Deepak-EL/robro/docs/figures/foxglove_coverage_run.png

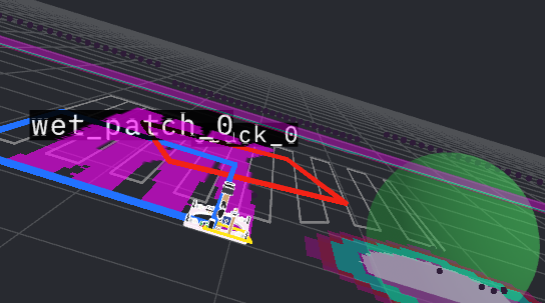
docs/figures/foxglove_coverage_run.png
