Deepak-EL/robro/docs/figures/foxglove_robot_model.png

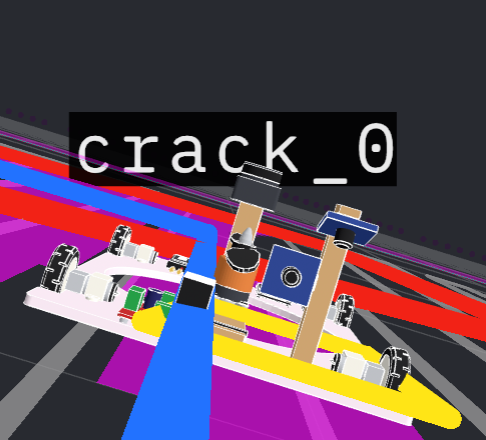
docs/figures/foxglove_robot_model.png
