Deepak-EL/robro/docs/figures/webots_goldeneye_robot_on_fitted_face.png

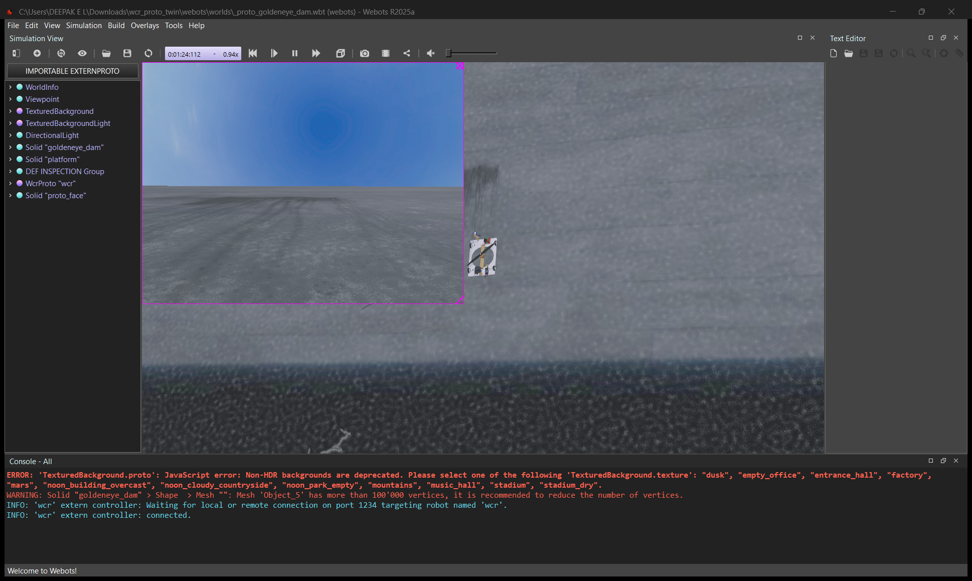
docs/figures/webots_goldeneye_robot_on_fitted_face.png
