Deepak-EL/robro/prototype_v2/cad/preview_top.png

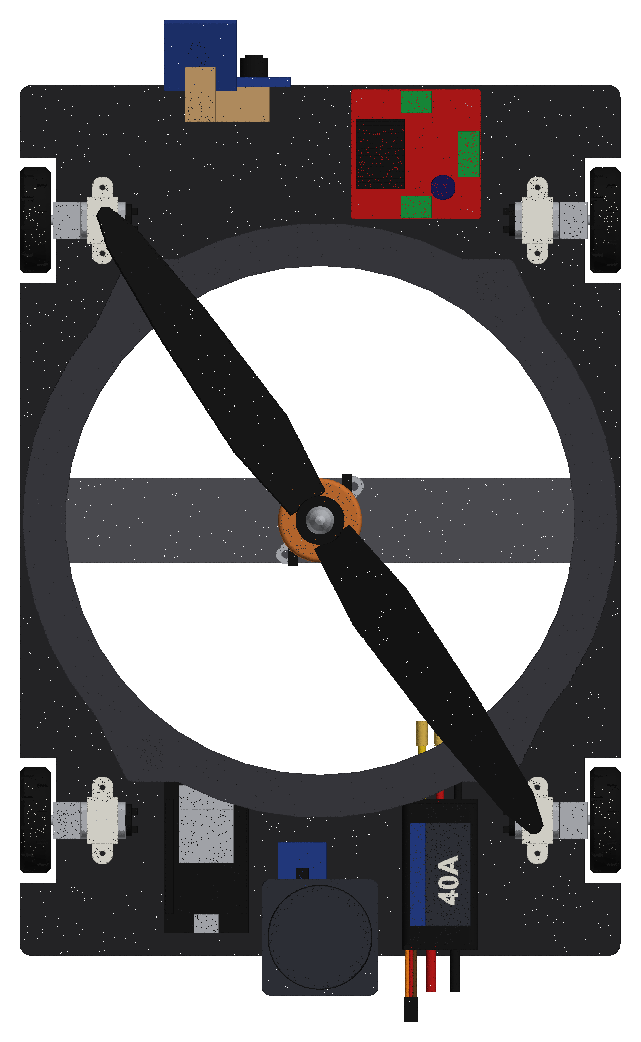
prototype_v2/cad/preview_top.png
