Deepak-EL/robro/prototype_v2/cad/urdf_check.png

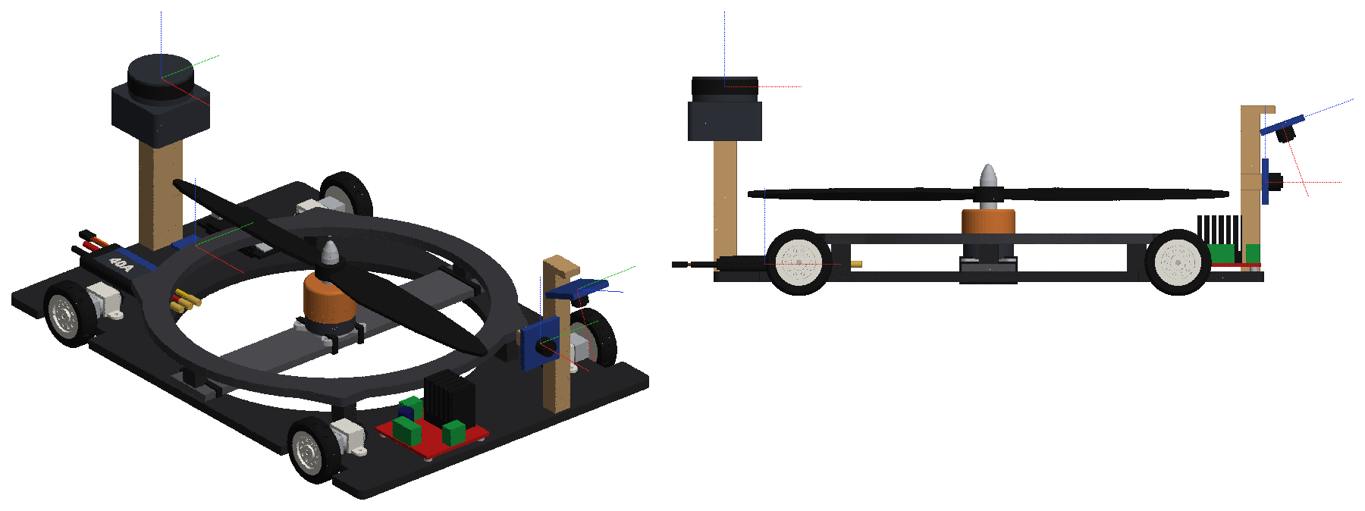
prototype_v2/cad/urdf_check.png
