Deepak-EL/robro/prototype_v2/docs/figures/hw/ref_1000kv_1045.jpg

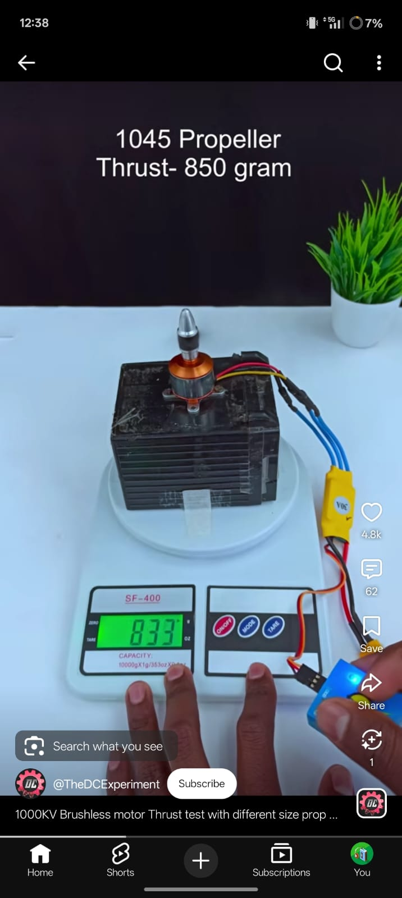
prototype_v2/docs/figures/hw/ref_1000kv_1045.jpg
