Deepak-EL/robro/prototype_v2/docs/figures/hw/ref_1000kv_6045.jpg

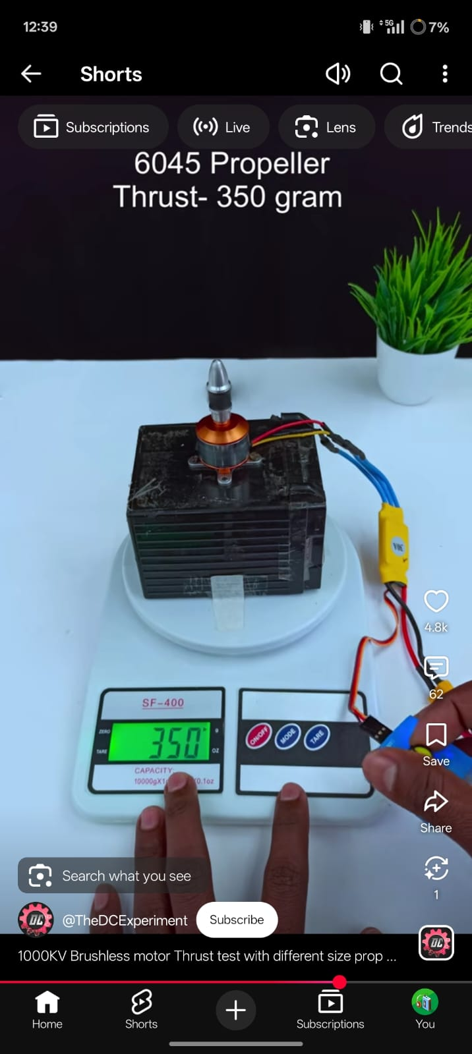
prototype_v2/docs/figures/hw/ref_1000kv_6045.jpg
