Deepak-EL/robro/prototype_v2/docs/figures/hw/robot_on_wall.jpg

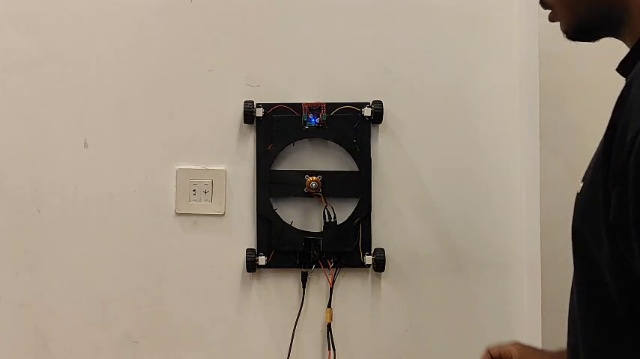
prototype_v2/docs/figures/hw/robot_on_wall.jpg
