Deepak-EL/robro/prototype_v2/docs/figures/hw/robot_weight_444g.jpg

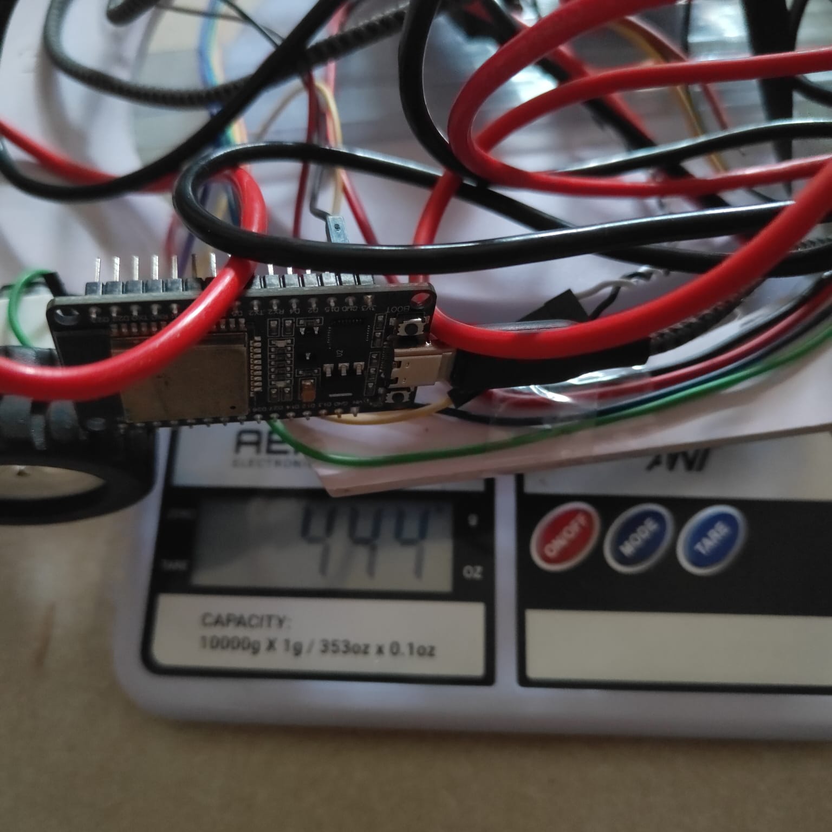
prototype_v2/docs/figures/hw/robot_weight_444g.jpg
