Deepak-EL/robro/prototype_v2/docs/figures/hw/v2_side.jpg

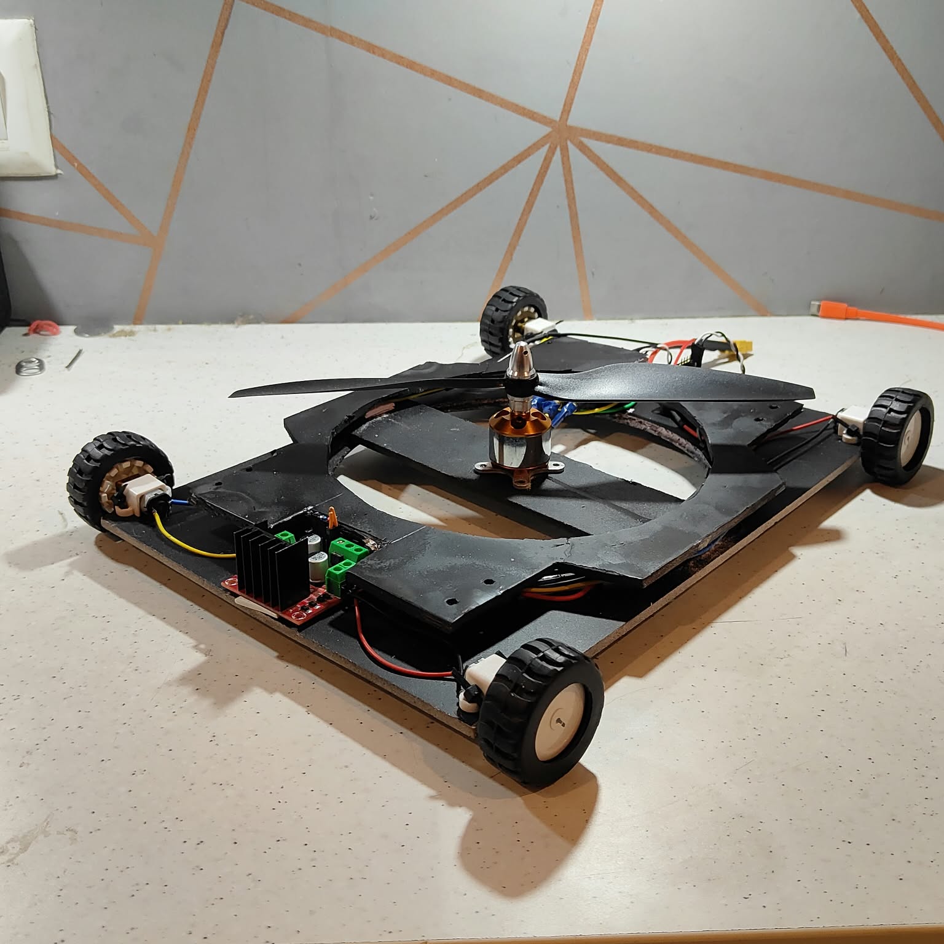
prototype_v2/docs/figures/hw/v2_side.jpg
