Deepak-EL/robro/prototype_v2/docs/figures/hw_n20_clamp.png

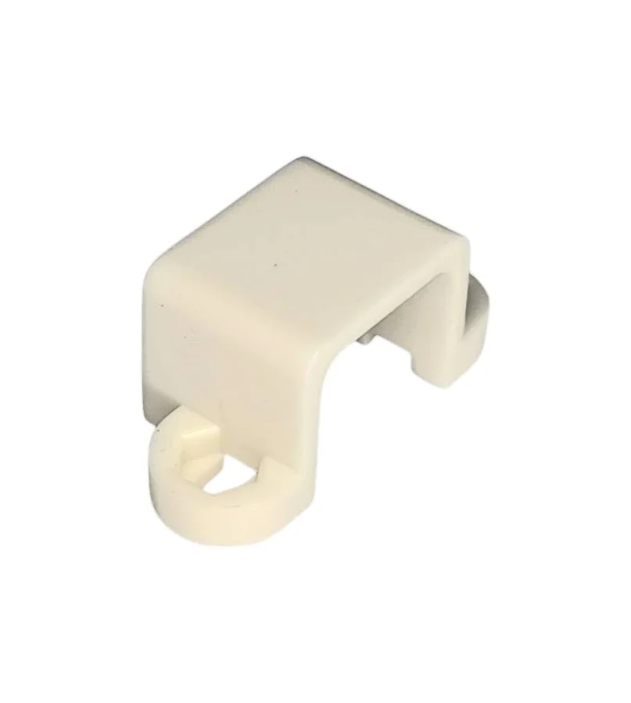
prototype_v2/docs/figures/hw_n20_clamp.png
