Deepak-EL/robro/prototype_v2/media/photos/WhatsApp Image 2026-10-24 at 18.57.05.jpeg

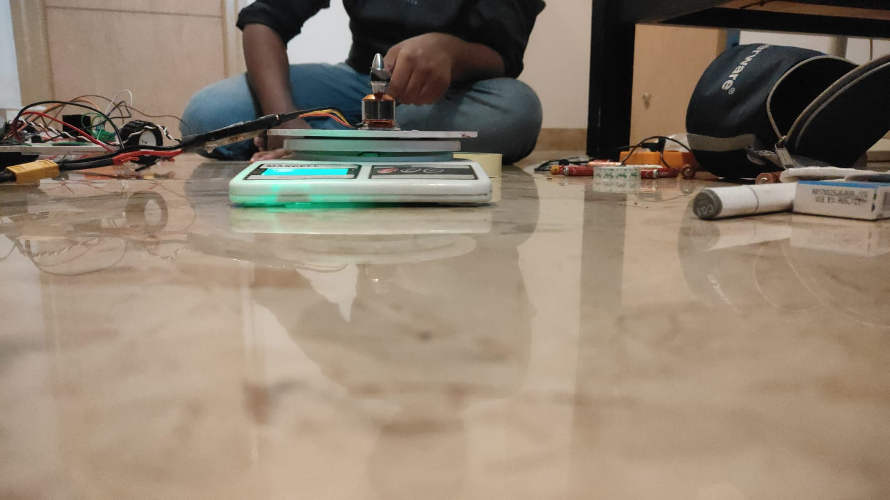
prototype_v2/media/photos/WhatsApp Image 2026-10-24 at 18.57.05.jpeg
