Deepak-EL/robro/prototype_v2/media/photos/WhatsApp Image 2026-10-27 at 12.44.45.jpeg

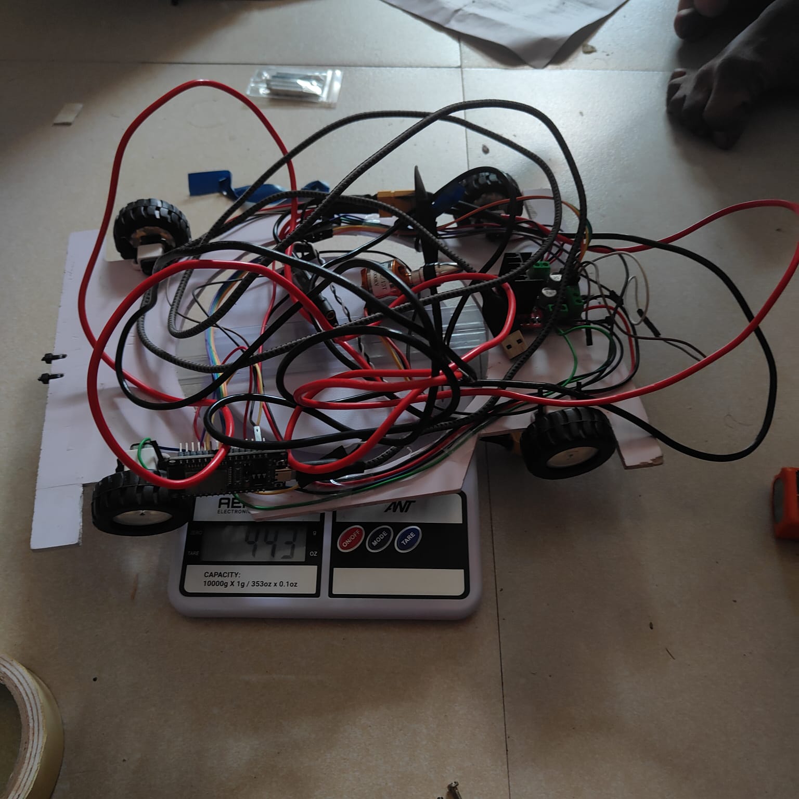
prototype_v2/media/photos/WhatsApp Image 2026-10-27 at 12.44.45.jpeg
