Deepak-EL/robro/prototype_v2/cad/wcr_proto2.step

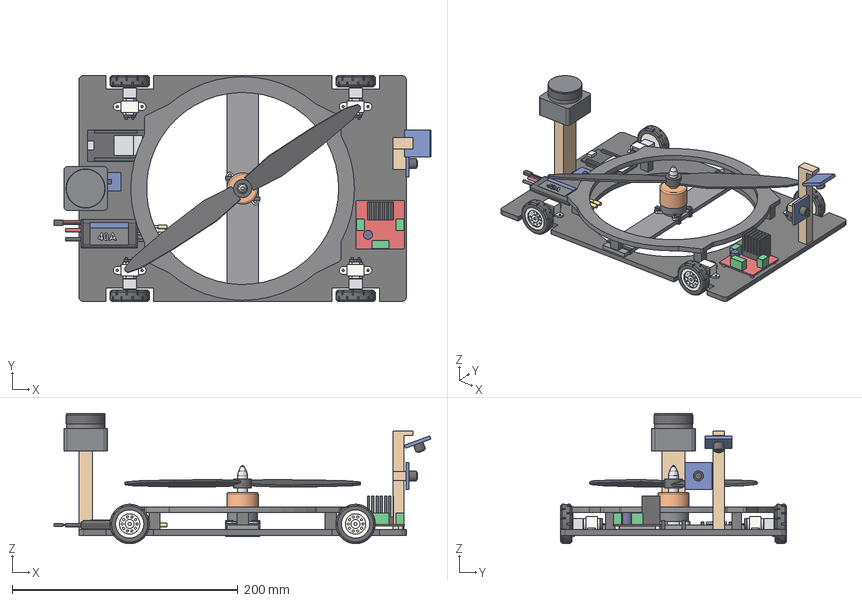
[picture p22: CAD file, 2026-11-06]
prototype_v2/cad/wcr_proto2.step
333.8 x 200.0 x 115.5 mm
foam_board
plywood_strip
top_deck
deck_spacer_0
deck_spacer_1
deck_spacer_2
deck_spacer_3
deck_spacer_4
deck_spacer_5
motor_mount
motor_stator
motor_bell
motor_shaft
zip_tie_motor_0
zip_tie_motor_1
zip_tie_strip_0
zip_tie_strip_1
propeller
spinner_nut
FL_n20_gearbox
FL_n20_can
FL_n20_endcap
FL_n20_clamp
FL_tyre
FL_hub
FR_n20_gearbox
FR_n20_can
FR_n20_endcap
FR_n20_clamp
FR_tyre
FR_hub
BL_n20_gearbox
BL_n20_can
BL_n20_endcap
BL_n20_clamp
BL_tyre
BL_hub
BR_n20_gearbox
BR_n20_can
BR_n20_endcap
BR_n20_clamp
BR_tyre
BR_hub
l298n_standoffs
l298n_pcb
l298n_heatsink
l298n_terminals
l298n_capacitor
esp32_pins
esp32_pcb
esp32_module
esp32_usb
esc_body
esc_label
esc_label_stripe
esc_label_text
esc_wires_black
esc_wires_gold
esc_wires_red
esc_wires_yellow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
