Deepak-EL/robro/prototype_v2/ros/wcr_proto2/meshes/body_2.stl

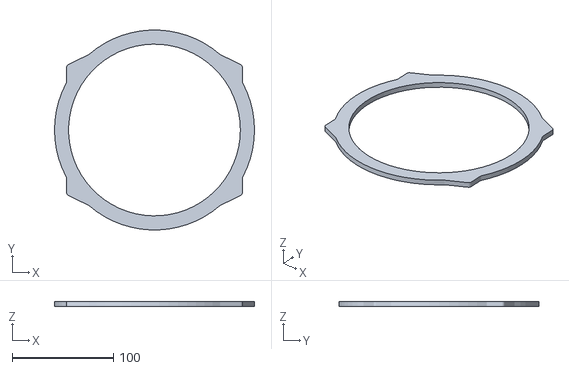
[picture p23: CAD file, 2026-11-06]
prototype_v2/ros/wcr_proto2/meshes/body_2.stl
198.0 x 197.8 x 5.00
