Deepak-EL/robro/prototype_v2/ros/wcr_proto2/meshes/body_0.stl

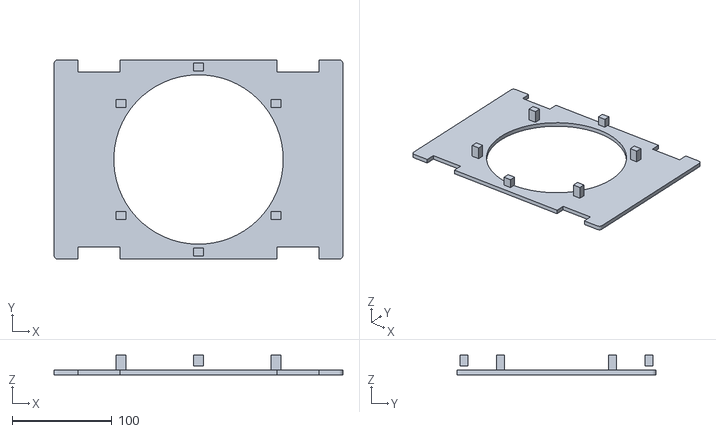
[picture p24: CAD file, 2026-11-06]
prototype_v2/ros/wcr_proto2/meshes/body_0.stl
290.0 x 200.0 x 20.0
