Deepak-EL/robro/prototype_v2/ros/wcr_proto2/meshes/body_1.stl

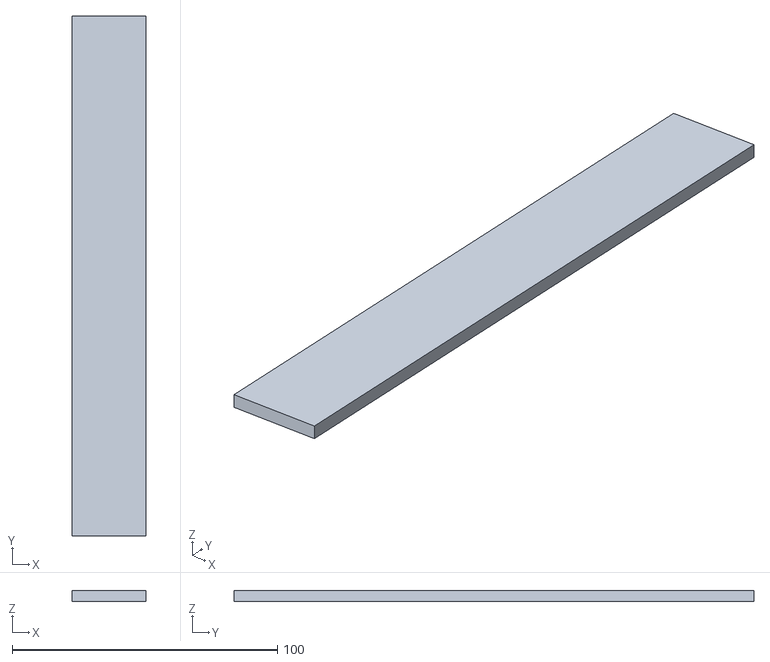
[picture p25: CAD file, 2026-11-06]
prototype_v2/ros/wcr_proto2/meshes/body_1.stl
28.0 x 196.0 x 4.00
