Deepak-EL/robro/prototype_v2/ros/wcr_proto2/meshes/body_16.stl

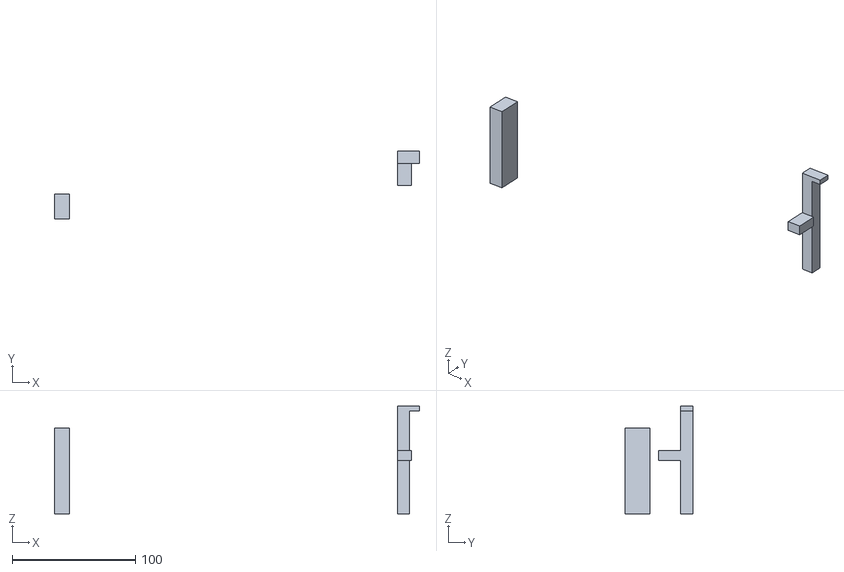
[picture p26: CAD file, 2026-11-06]
prototype_v2/ros/wcr_proto2/meshes/body_16.stl
296.0 x 55.0 x 87.5
