Deepak-EL/robro/prototype_v2/ros/wcr_proto2/meshes/body_6.stl

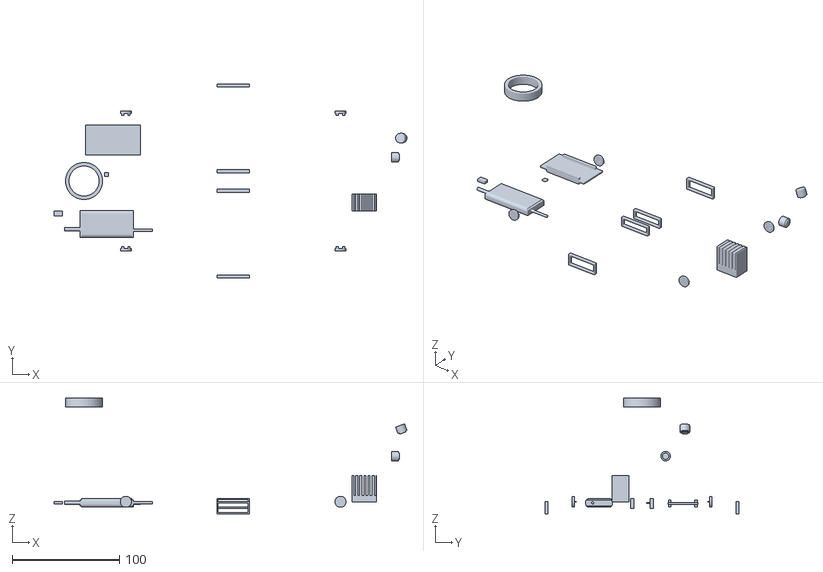
[picture p27: CAD file, 2026-11-06]
prototype_v2/ros/wcr_proto2/meshes/body_6.stl
329.0 x 181.0 x 107.7
