Deepak-EL/robro/prototype_v2/ros/wcr_proto2/meshes/body_11.stl

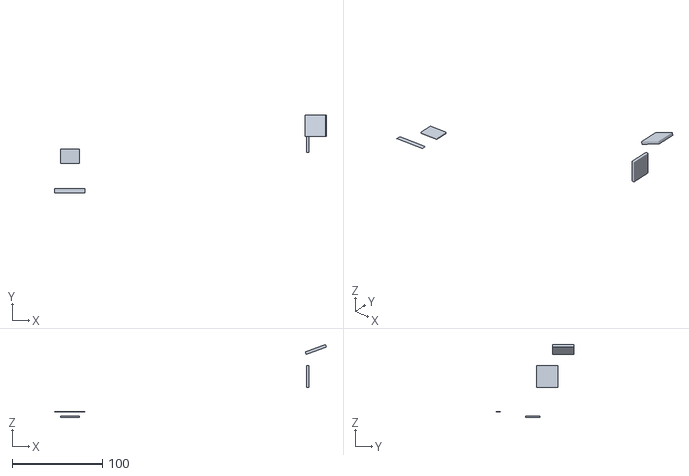
[picture p28: CAD file, 2026-11-04]
prototype_v2/ros/wcr_proto2/meshes/body_11.stl
301.8 x 87.0 x 81.0
