Deepak-EL/robro/prototype_v2/ros/wcr_proto2/meshes/body_5.stl

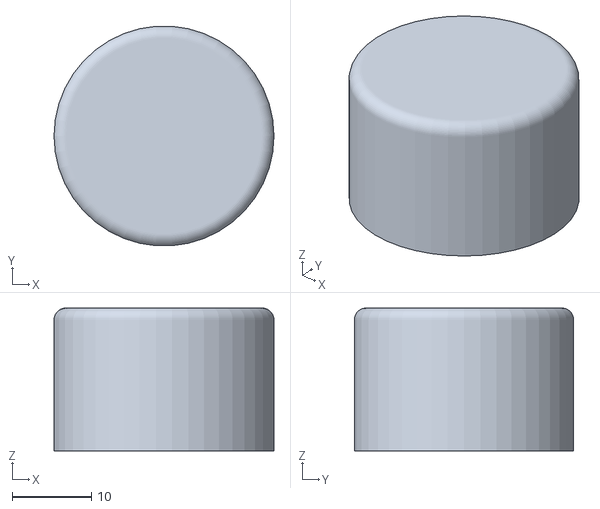
[picture p29: CAD file, 2026-11-04]
prototype_v2/ros/wcr_proto2/meshes/body_5.stl
27.7 x 27.6 x 18.0
