Deepak-EL/robro/prototype_v2/ros/wcr_proto2/meshes/body_12.stl

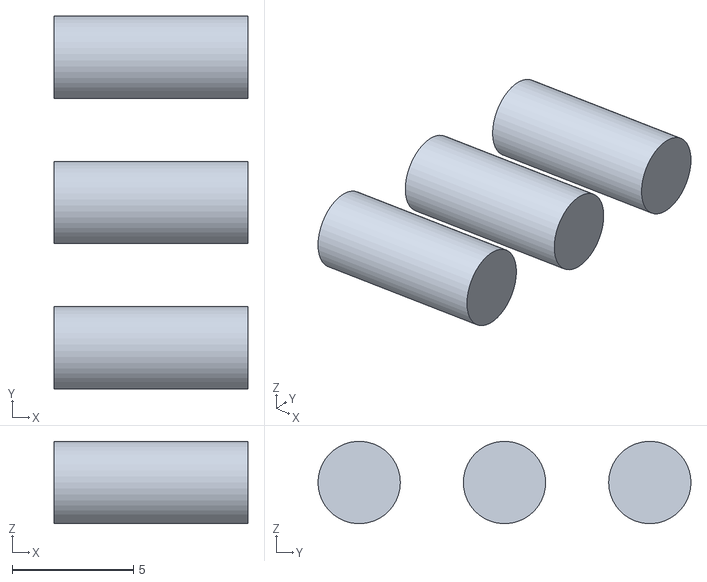
[picture p30: CAD file, 2026-11-04]
prototype_v2/ros/wcr_proto2/meshes/body_12.stl
8.00 x 15.4 x 3.39
