Deepak-EL/robro/prototype_v2/ros/wcr_proto2/meshes/prop_0.stl

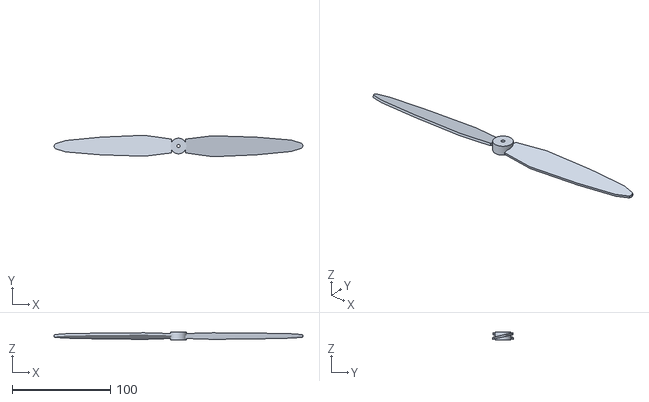
[picture p31: CAD file, 2026-11-04]
prototype_v2/ros/wcr_proto2/meshes/prop_0.stl
254.0 x 21.9 x 8.00
