Deepak-EL/robro/prototype_v2/ros/wcr_proto2/meshes/body_7.stl

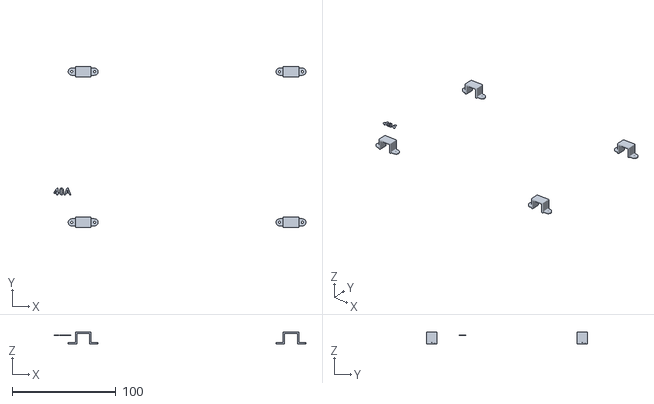
[picture p32: CAD file, 2026-11-04]
prototype_v2/ros/wcr_proto2/meshes/body_7.stl
242.5 x 155.0 x 11.7
