Deepak-EL/robro/prototype_v2/ros/wcr_proto2/meshes/body_4.stl

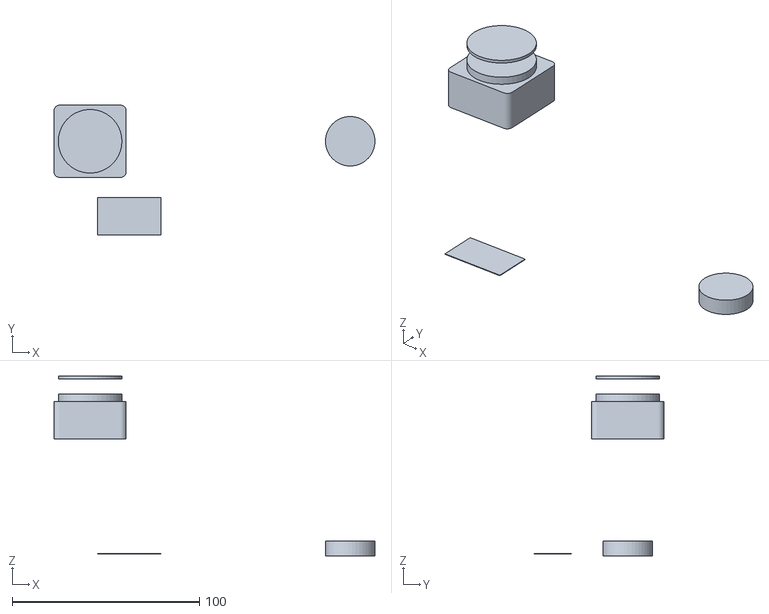
[picture p33: CAD file, 2026-11-04]
prototype_v2/ros/wcr_proto2/meshes/body_4.stl
171.6 x 69.3 x 96.0
