Deepak-EL/robro/prototype_v2/ros/wcr_proto2/meshes/body_13.stl

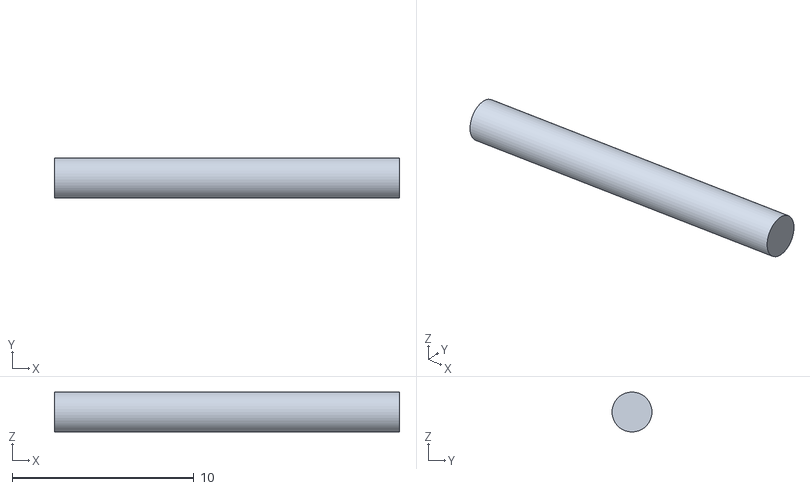
[picture p34: CAD file, 2026-11-04]
prototype_v2/ros/wcr_proto2/meshes/body_13.stl
19.0 x 2.20 x 2.19
