Deepak-EL/robro/prototype_v2/ros/wcr_proto2/meshes/wheel_0.stl

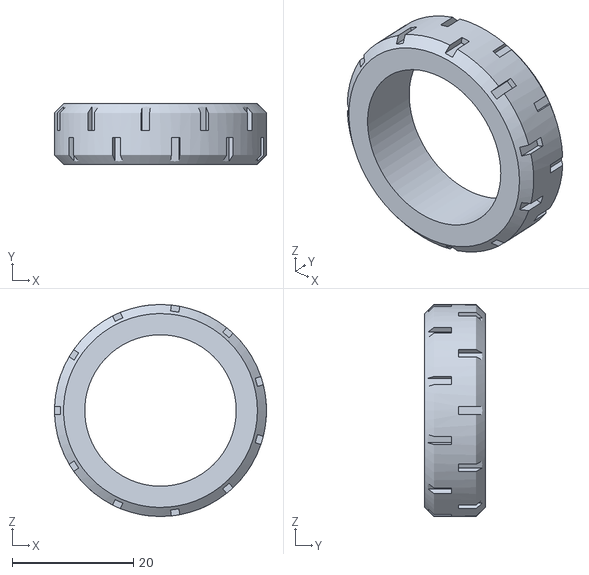
[picture p35: CAD file, 2026-11-04]
prototype_v2/ros/wcr_proto2/meshes/wheel_0.stl
35.0 x 10.0 x 35.0
