Deepak-EL/robro/prototype_v2/ros/wcr_proto2/meshes/body_15.stl

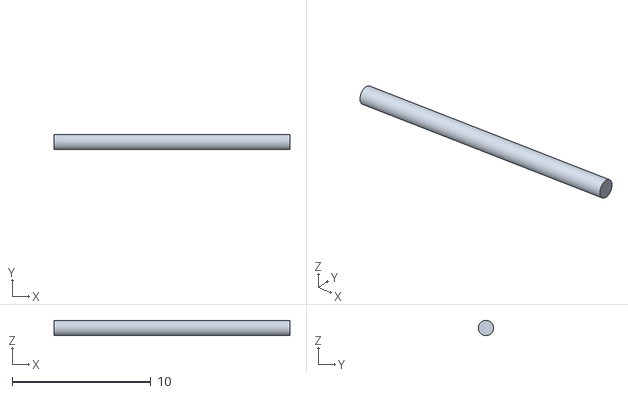
[picture p36: CAD file, 2026-11-04]
prototype_v2/ros/wcr_proto2/meshes/body_15.stl
17.0 x 1.10 x 1.10
