Deepak-EL/robro/prototype_v2/ros/wcr_proto2/meshes/wheel_1.stl

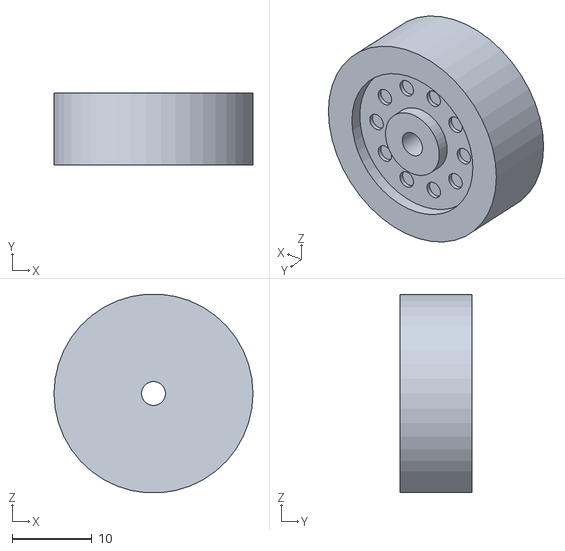
[picture p37: CAD file, 2026-11-04]
prototype_v2/ros/wcr_proto2/meshes/wheel_1.stl
25.0 x 9.00 x 24.9
