Deepak-EL/robro/prototype_v2/ros/wcr_proto2/meshes/body_10.stl

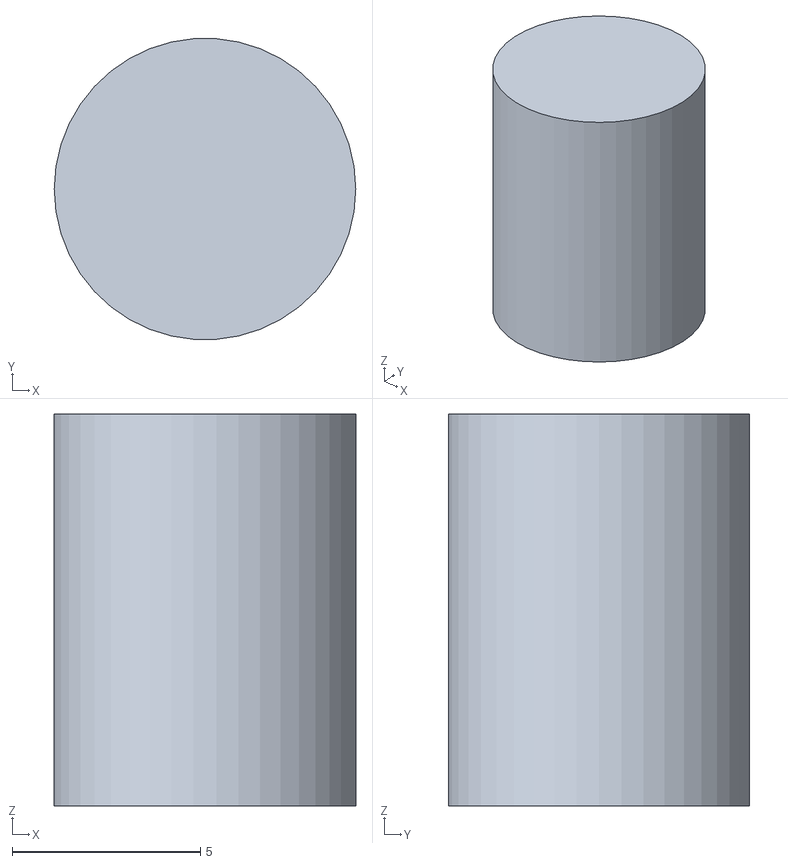
[picture p38: CAD file, 2026-11-04]
prototype_v2/ros/wcr_proto2/meshes/body_10.stl
8.00 x 7.98 x 10.4
