Deepak-EL/robro/prototype_v2/ros/wcr_proto2/meshes/body_3.stl

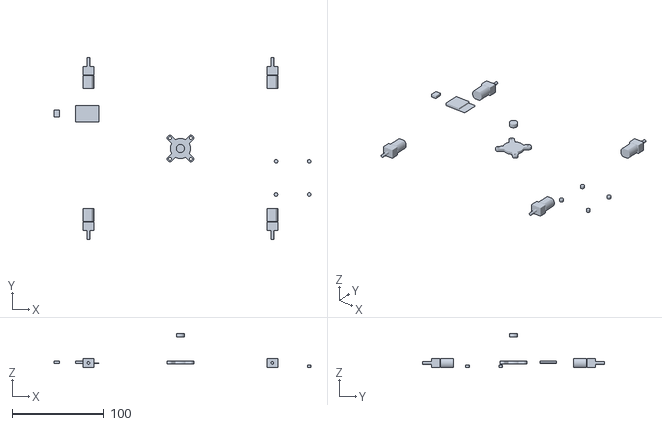
[picture p39: CAD file, 2026-11-04]
prototype_v2/ros/wcr_proto2/meshes/body_3.stl
279.5 x 198.0 x 37.0
