Deepak-EL/robro/prototype_v2/ros/wcr_proto2/meshes/body_9.stl

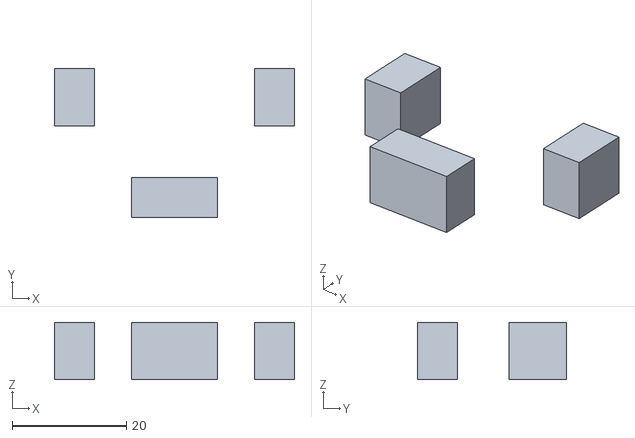
[picture p40: CAD file, 2026-11-04]
prototype_v2/ros/wcr_proto2/meshes/body_9.stl
42.0 x 26.0 x 10.0
