Deepak-EL/robro/prototype_v2/ros/wcr_proto2/meshes/prop_1.stl

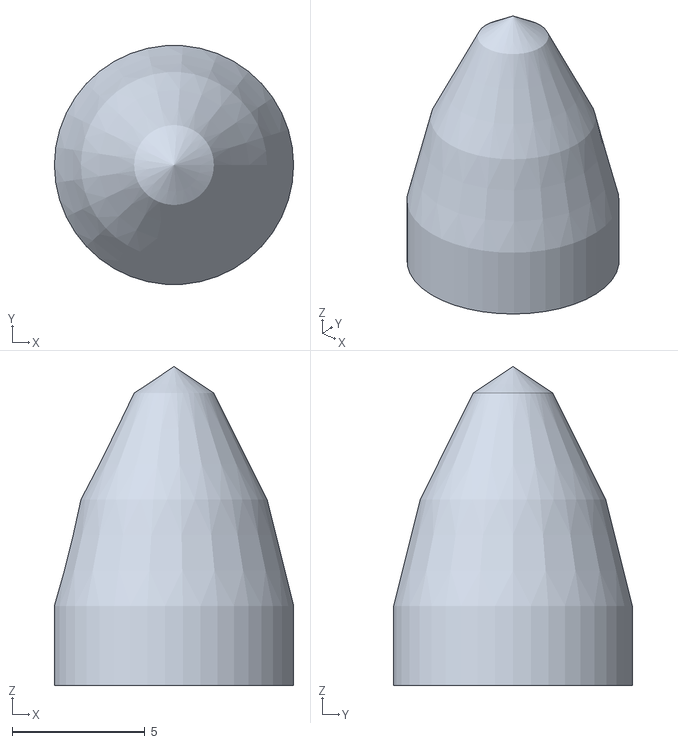
[picture p41: CAD file, 2026-11-04]
prototype_v2/ros/wcr_proto2/meshes/prop_1.stl
9.00 x 8.97 x 12.0
