Deepak-EL/robro/prototype_v2/ros/wcr_proto2/meshes/body_8.stl

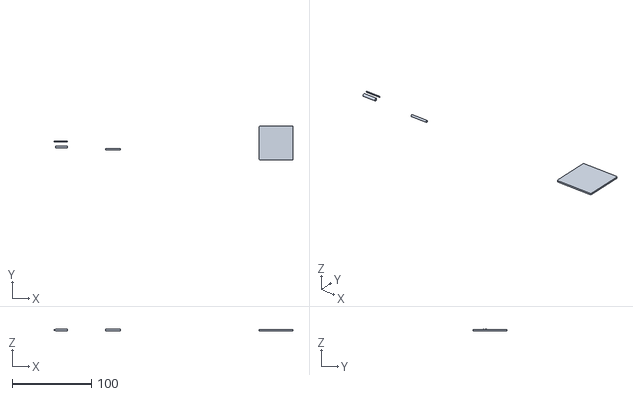
[picture p42: CAD file, 2026-11-04]
prototype_v2/ros/wcr_proto2/meshes/body_8.stl
302.5 x 43.0 x 2.99
