Deepak-EL/robro/(list of files, cad)

Other CAD files:
prototype_v2/ros/wcr_proto2/meshes/body_14.stl
prototype_v2/ros/wcr_proto2/meshes/body_0.obj
prototype_v2/ros/wcr_proto2/meshes/body_1.obj
prototype_v2/ros/wcr_proto2/meshes/body_10.obj
prototype_v2/ros/wcr_proto2/meshes/body_11.obj
prototype_v2/ros/wcr_proto2/meshes/body_12.obj
prototype_v2/ros/wcr_proto2/meshes/body_13.obj
prototype_v2/ros/wcr_proto2/meshes/body_14.obj
prototype_v2/ros/wcr_proto2/meshes/body_15.obj
prototype_v2/ros/wcr_proto2/meshes/body_16.obj
prototype_v2/ros/wcr_proto2/meshes/body_2.obj
prototype_v2/ros/wcr_proto2/meshes/body_3.obj
prototype_v2/ros/wcr_proto2/meshes/body_4.obj
prototype_v2/ros/wcr_proto2/meshes/body_5.obj
prototype_v2/ros/wcr_proto2/meshes/body_6.obj
prototype_v2/ros/wcr_proto2/meshes/body_7.obj
prototype_v2/ros/wcr_proto2/meshes/body_8.obj
prototype_v2/ros/wcr_proto2/meshes/body_9.obj
prototype_v2/ros/wcr_proto2/meshes/prop_0.obj
prototype_v2/ros/wcr_proto2/meshes/prop_1.obj
prototype_v2/ros/wcr_proto2/meshes/wheel_0.obj
prototype_v2/ros/wcr_proto2/meshes/wheel_1.obj
