Deepak-EL/robro/prototype_v2/docs/figures/wiring_diagram.png

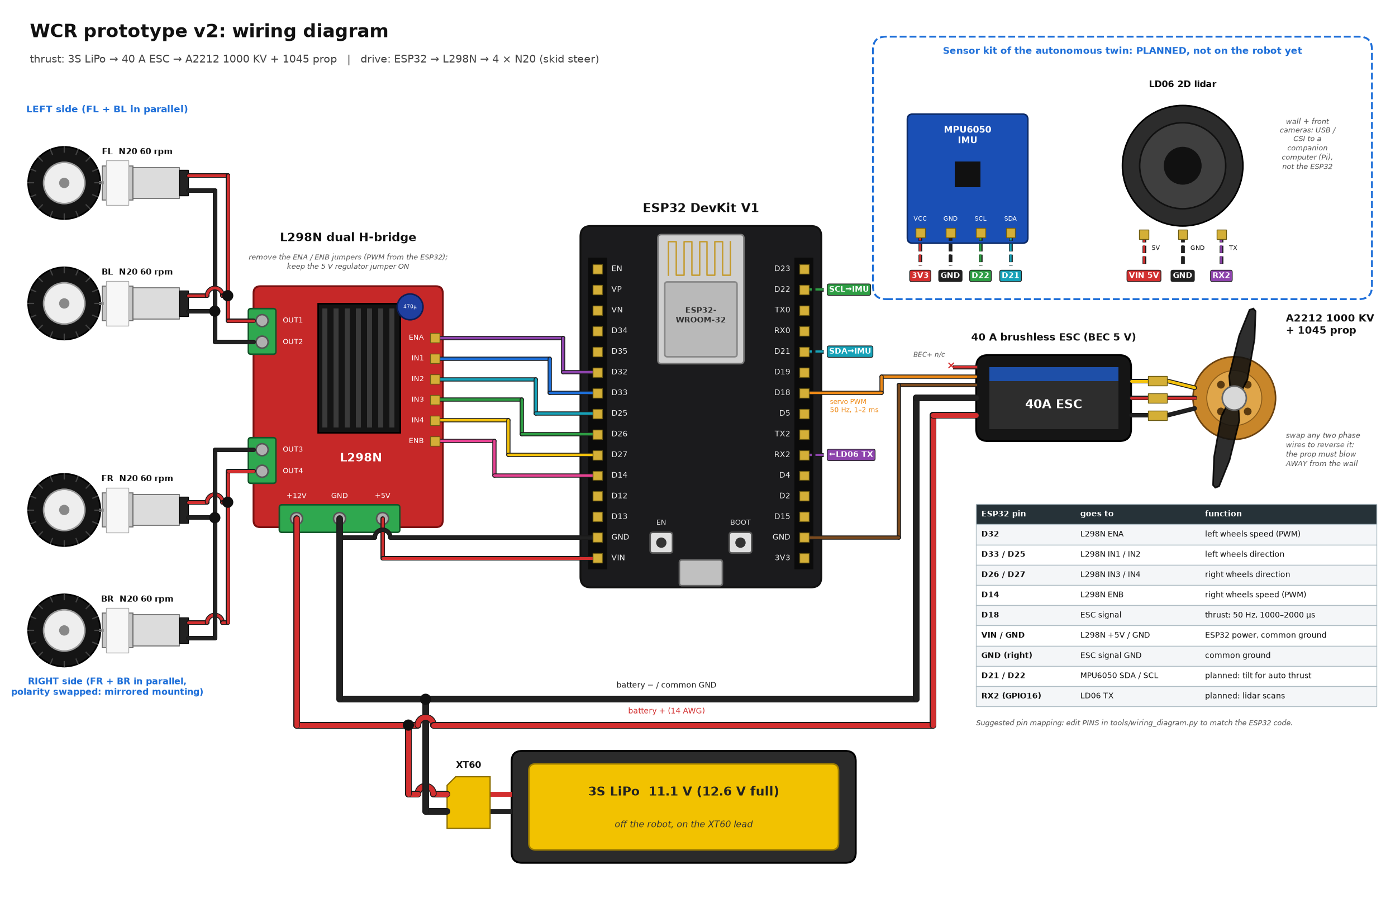
prototype_v2/docs/figures/wiring_diagram.png
