Deepak-EL/robro/prototype_v2/docs/figures/wiring_diagram_user.png

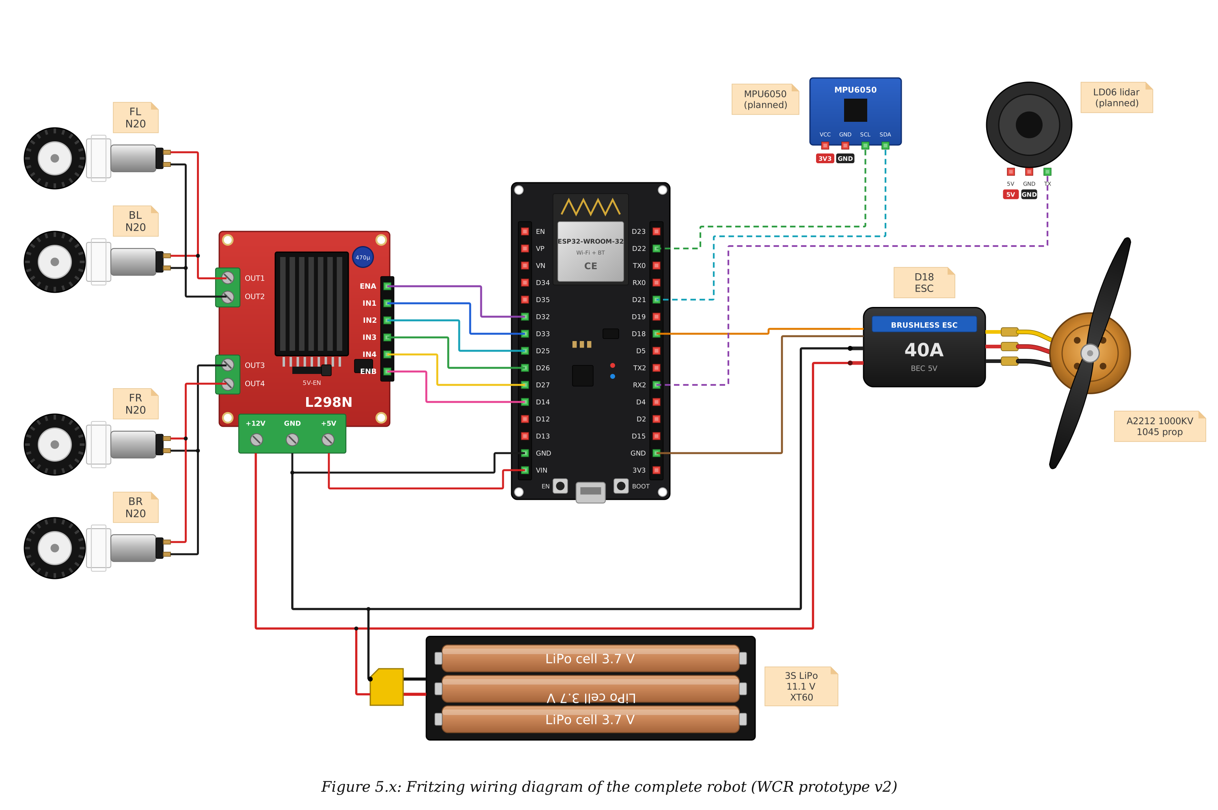
prototype_v2/docs/figures/wiring_diagram_user.png
