Deepak-EL/robro/results/final/inspection_log_goldeneye_gorge.csv

sim_time_s | id | type | s_m | t_m | x | y | z | robot_x | robot_y | robot_z | points_in_view | visible_fraction
16.5 | crack_0 | crack | 2.1 | -0.07 | -22.0589 | 0.697 | -102.4002 | -22.219 | 0.748 | -102.507 | 5 | 0.03
22.5 | wet_patch_0 | wet_patch | 2.85 | -0.5 | -22.4669 | 0.8331 | -101.6502 | -22.504 | 0.844 | -101.927 | 4 | 0.03
