Deepak-EL/robro/results/final/inspection_log_winter_dam.csv

sim_time_s | id | type | s_m | t_m | x | y | z | robot_x | robot_y | robot_z | points_in_view | visible_fraction
17.19 | crack_0 | crack | 2.8 | -0.07 | 0.07 | 1.6637 | 2.2521 | 0.239 | 1.605 | 2.172 | 6 | 0.04
23.19 | wet_patch_0 | wet_patch | 3.55 | -0.5 | 0.5 | 2.1094 | 2.8554 | 0.536 | 1.95 | 2.639 | 4 | 0.03
