Deepak-EL/robro/prototype_v2/docs/figures/hw/thrust_test_bench.jpg

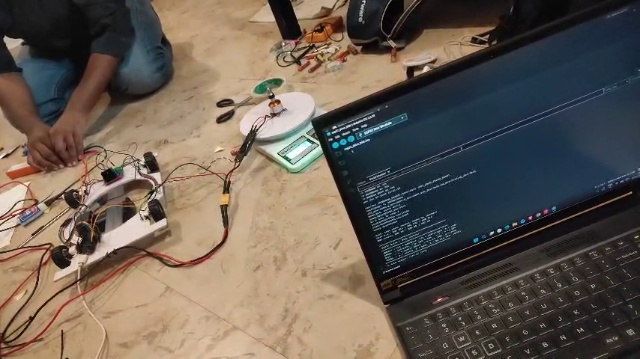
prototype_v2/docs/figures/hw/thrust_test_bench.jpg
