Deepak-EL/robro/prototype_v2/docs/figures/hw/thrust_test_scale_296g.jpg

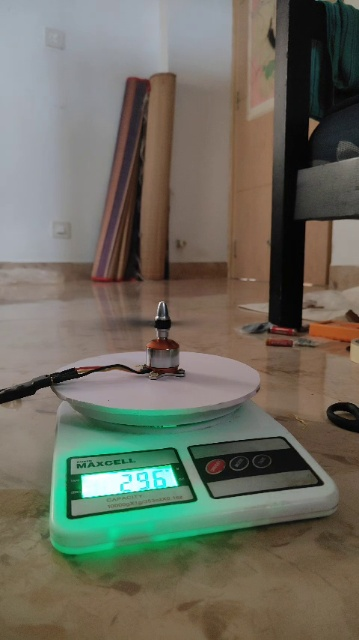
prototype_v2/docs/figures/hw/thrust_test_scale_296g.jpg
