Deepak-EL/robro/prototype_v2/results/coverage_goldeneye_dam.png

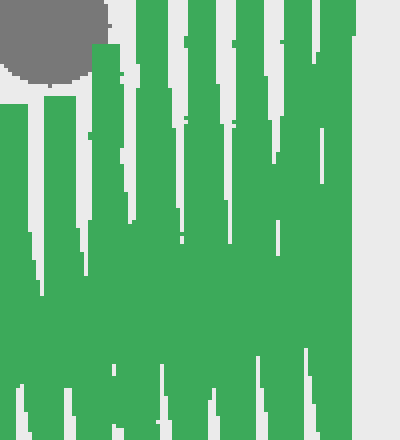
prototype_v2/results/coverage_goldeneye_dam.png
