Deepak-EL/robro/prototype_v2/results/coverage_goldeneye_gorge.png

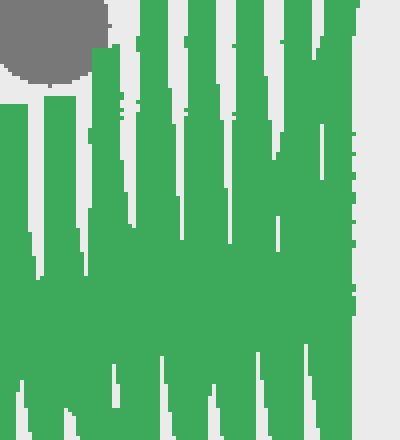
prototype_v2/results/coverage_goldeneye_gorge.png
