Deepak-EL/robro/prototype_v2/results/coverage_winter_dam.png

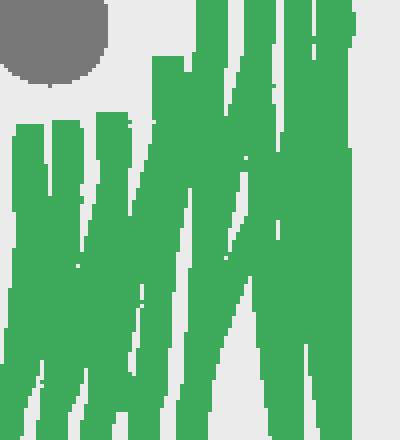
prototype_v2/results/coverage_winter_dam.png
