Deepak-EL/robro/docs/figures/issue1_winter_stuck_turning.png

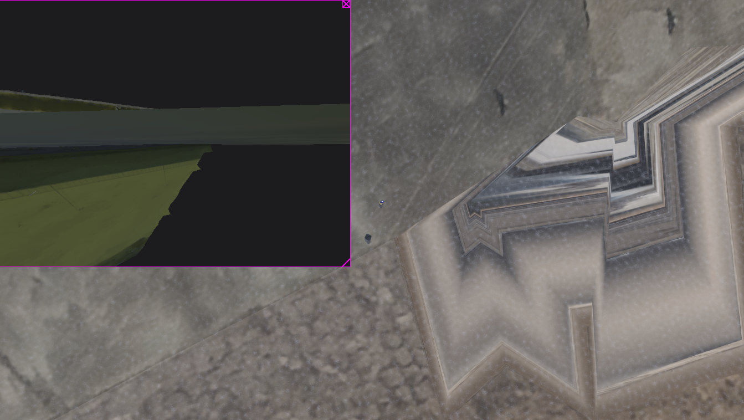
docs/figures/issue1_winter_stuck_turning.png
