Deepak-EL/robro/docs/figures/issue3_gorge_fell_cameras_sky.png

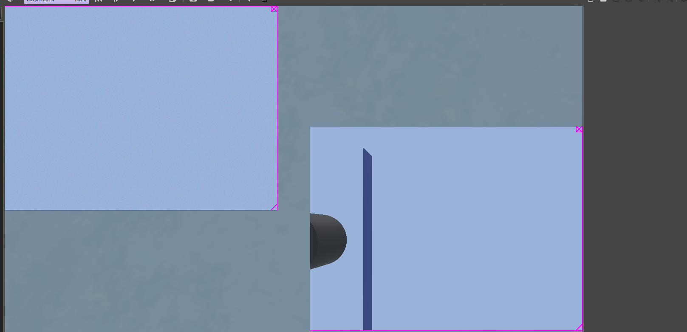
docs/figures/issue3_gorge_fell_cameras_sky.png
