Deepak-EL/robro/docs/figures/issue4_two_webots_instances.png

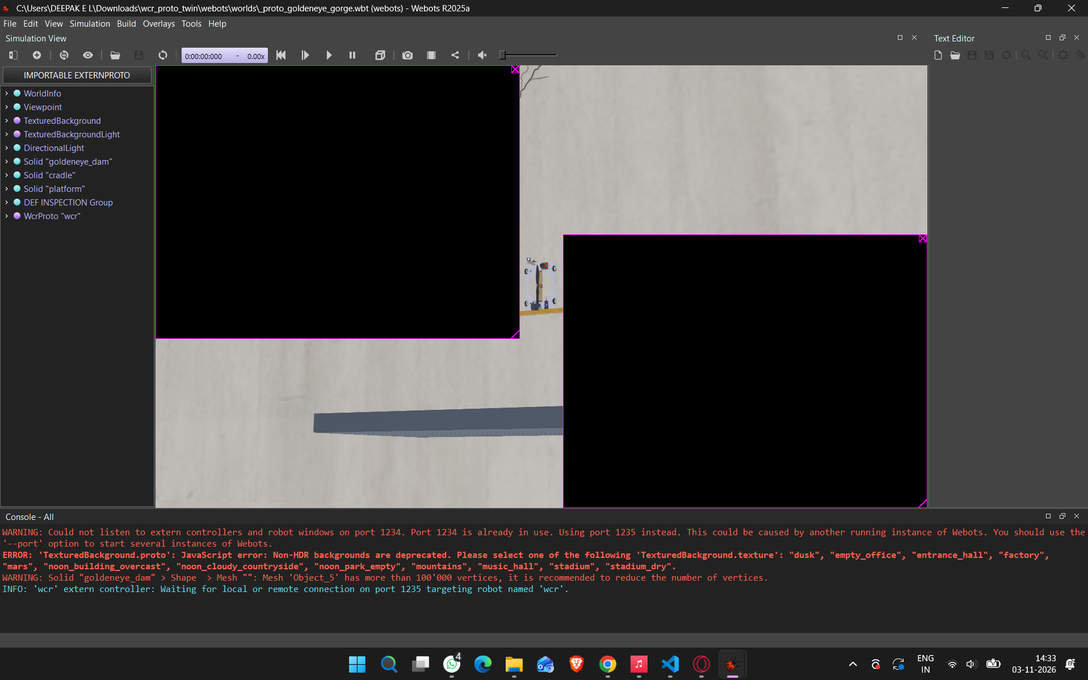
docs/figures/issue4_two_webots_instances.png
