Deepak-EL/robro/docs/figures/issue6_foxglove_edge_on_view.png

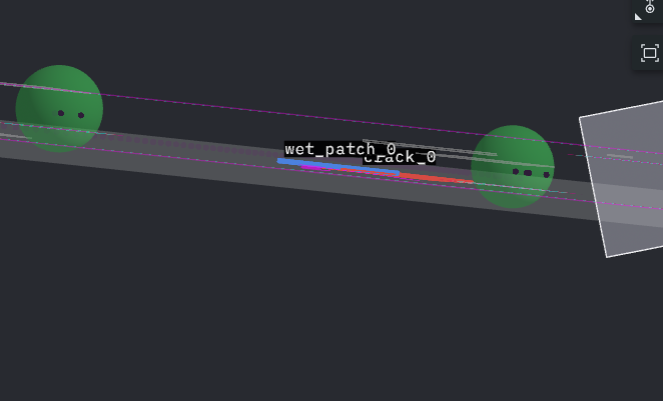
docs/figures/issue6_foxglove_edge_on_view.png
