Deepak-EL/robro/docs/figures/issue7_foxglove_slanted_grid.png

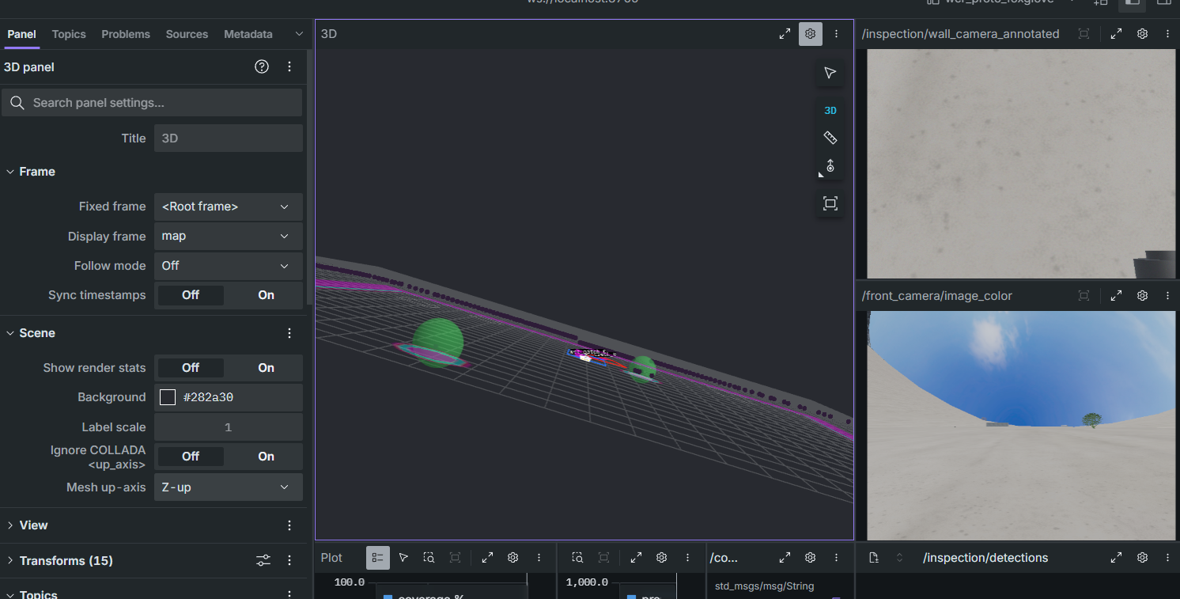
docs/figures/issue7_foxglove_slanted_grid.png
