Deepak-EL/robro/ros/wcr_proto/resource/wcr_proto.urdf

<?xml version="1.0"?>
<!-- Generated by tools/build_proto_webots.py: the WCR prototype (base_link = wall contact plane). Visual only; physics lives in webots/protos/WcrProto.proto. -->
<robot name="wcr">
<material name="c_ef_e0_ea"><color rgba="0.940 0.880 0.920 1"/></material>
<material name="c_c6_9e_6b"><color rgba="0.780 0.620 0.420 1"/></material>
<material name="c_b7_ba_bf"><color rgba="0.720 0.730 0.750 1"/></material>
<material name="c_33_35_3d"><color rgba="0.200 0.210 0.240 1"/></material>
<material name="c_cc_72_33"><color rgba="0.800 0.450 0.200 1"/></material>
<material name="c_0f_0f_11"><color rgba="0.060 0.060 0.070 1"/></material>
<material name="c_ed_ea_e0"><color rgba="0.930 0.920 0.880 1"/></material>
<material name="c_bf_19_19"><color rgba="0.750 0.100 0.100 1"/></material>
<material name="c_19_99_3f"><color rgba="0.100 0.600 0.250 1"/></material>
<material name="c_19_19_59"><color rgba="0.100 0.100 0.350 1"/></material>
<material name="c_26_3f_8c"><color rgba="0.150 0.250 0.550 1"/></material>
<material name="c_d8_b2_4c"><color rgba="0.850 0.700 0.300 1"/></material>
<material name="c_e5_bf_19"><color rgba="0.900 0.750 0.100 1"/></material>
<material name="c_66_3f_1e"><color rgba="0.400 0.250 0.120 1"/></material>
<material name="c_f2_7f_19"><color rgba="0.950 0.500 0.100 1"/></material>
<material name="c_11_11_14"><color rgba="0.070 0.070 0.080 1"/></material>
<link name="base_link"><visual><origin xyz="0 0 0.00750" rpy="0 0 0"/><geometry><mesh filename="package://wcr_proto/meshes/body_0.stl" scale="0.001 0.001 0.001"/></geometry><material name="c_ef_e0_ea"/></visual><visual><origin xyz="0 0 0.00750" rpy="0 0 0"/><geometry><mesh filename="package://wcr_proto/meshes/body_1.stl" scale="0.001 0.001 0.001"/></geometry><material name="c_c6_9e_6b"/></visual><visual><origin xyz="0 0 0.00750" rpy="0 0 0"/><geometry><mesh filename="package://wcr_proto/meshes/body_2.stl" scale="0.001 0.001 0.001"/></geometry><material name="c_b7_ba_bf"/></visual><visual><origin xyz="0 0 0.00750" rpy="0 0 0"/><geometry><mesh filename="package://wcr_proto/meshes/body_3.stl" scale="0.001 0.001 0.001"/></geometry><material name="c_33_35_3d"/></visual><visual><origin xyz="0 0 0.00750" rpy="0 0 0"/><geometry><mesh filename="package://wcr_proto/meshes/body_4.stl" scale="0.001 0.001 0.001"/></geometry><material name="c_cc_72_33"/></visual><visual><origin xyz="0 0 0.00750" rpy="0 0 0"/><geometry><mesh filename="package://wcr_proto/meshes/body_5.stl" scale="0.001 0.001 0.001"/></geometry><material name="c_0f_0f_11"/></visual><visual><origin xyz="0 0 0.00750" rpy="0 0 0"/><geometry><mesh filename="package://wcr_proto/meshes/body_6.stl" scale="0.001 0.001 0.001"/></geometry><material name="c_ed_ea_e0"/></visual><visual><origin xyz="0 0 0.00750" rpy="0 0 0"/><geometry><mesh filename="package://wcr_proto/meshes/body_7.stl" scale="0.001 0.001 0.001"/></geometry><material name="c_bf_19_19"/></visual><visual><origin xyz="0 0 0.00750" rpy="0 0 0"/><geometry><mesh filename="package://wcr_proto/meshes/body_8.stl" scale="0.001 0.001 0.001"/></geometry><material name="c_19_99_3f"/></visual><visual><origin xyz="0 0 0.00750" rpy="0 0 0"/><geometry><mesh filename="package://wcr_proto/meshes/body_9.stl" scale="0.001 0.001 0.001"/></geometry><material name="c_19_19_59"/></visual><visual><origin xyz="0 0 0.00750" rpy="0 0 0"/><geometry><mesh filename="package://wcr_proto/meshes/body_10.stl" scale="0.001 0.001 0.001"/></geometry><material name="c_26_3f_8c"/></visual><visual><origin xyz="0 0 0.00750" rpy="0 0 0"/><geometry><mesh filename="package://wcr_proto/meshes/body_11.stl" scale="0.001 0.001 0.001"/></geometry><material name="c_d8_b2_4c"/></visual><visual><origin xyz="0 0 0.00750" rpy="0 0 0"/><geometry><mesh filename="package://wcr_proto/meshes/body_12.stl" scale="0.001 0.001 0.001"/></geometry><material name="c_e5_bf_19"/></visual><visual><origin xyz="0 0 0.00750" rpy="0 0 0"/><geometry><mesh filename="package://wcr_proto/meshes/body_13.stl" scale="0.001 0.001 0.001"/></geometry><material name="c_66_3f_1e"/></visual><visual><origin xyz="0 0 0.00750" rpy="0 0 0"/><geometry><mesh filename="package://wcr_proto/meshes/body_14.stl" scale="0.001 0.001 0.001"/></geometry><material name="c_f2_7f_19"/></visual></link>
<link name="prop_link"><visual><origin xyz="0 0 0" rpy="0 0 0"/><geometry><mesh filename="package://wcr_proto/meshes/prop_0.stl" scale="0.001 0.001 0.001"/></geometry><material name="c_0f_0f_11"/></visual><visual><origin xyz="0 0 0" rpy="0 0 0"/><geometry><mesh filename="package://wcr_proto/meshes/prop_1.stl" scale="0.001 0.001 0.001"/></geometry><material name="c_b7_ba_bf"/></visual></link>
<joint name="prop_joint" type="continuous"><parent link="base_link"/><child link="prop_link"/><origin xyz="0.00000 0.00000 0.05350" rpy="0.00000 0.00000 0.00000"/><axis xyz="0 0 1"/></joint>
<link name="FL_wheel_link"><visual><origin xyz="0 0 0" rpy="0 0 0"/><geometry><mesh filename="package://wcr_proto/meshes/wheel_0.stl" scale="0.001 0.001 0.001"/></geometry><material name="c_11_11_14"/></visual><visual><origin xyz="0 0 0" rpy="0 0 0"/><geometry><mesh filename="package://wcr_proto/meshes/wheel_1.stl" scale="0.001 0.001 0.001"/></geometry><material name="c_ed_ea_e0"/></visual></link>
<joint name="FL_wheel_joint" type="continuous"><parent link="base_link"/><child link="FL_wheel_link"/><origin xyz="0.10000 0.09500 0.01750" rpy="0.00000 0.00000 0.00000"/><axis xyz="0 1 0"/></joint>
<link name="FR_wheel_link"><visual><origin xyz="0 0 0" rpy="0 0 3.14159"/><geometry><mesh filename="package://wcr_proto/meshes/wheel_0.stl" scale="0.001 0.001 0.001"/></geometry><material name="c_11_11_14"/></visual><visual><origin xyz="0 0 0" rpy="0 0 3.14159"/><geometry><mesh filename="package://wcr_proto/meshes/wheel_1.stl" scale="0.001 0.001 0.001"/></geometry><material name="c_ed_ea_e0"/></visual></link>
<joint name="FR_wheel_joint" type="continuous"><parent link="base_link"/><child link="FR_wheel_link"/><origin xyz="0.10000 -0.09500 0.01750" rpy="0.00000 0.00000 0.00000"/><axis xyz="0 1 0"/></joint>
<link name="BL_wheel_link"><visual><origin xyz="0 0 0" rpy="0 0 0"/><geometry><mesh filename="package://wcr_proto/meshes/wheel_0.stl" scale="0.001 0.001 0.001"/></geometry><material name="c_11_11_14"/></visual><visual><origin xyz="0 0 0" rpy="0 0 0"/><geometry><mesh filename="package://wcr_proto/meshes/wheel_1.stl" scale="0.001 0.001 0.001"/></geometry><material name="c_ed_ea_e0"/></visual></link>
<joint name="BL_wheel_joint" type="continuous"><parent link="base_link"/><child link="BL_wheel_link"/><origin xyz="-0.10000 0.09500 0.01750" rpy="0.00000 0.00000 0.00000"/><axis xyz="0 1 0"/></joint>
<link name="BR_wheel_link"><visual><origin xyz="0 0 0" rpy="0 0 3.14159"/><geometry><mesh filename="package://wcr_proto/meshes/wheel_0.stl" scale="0.001 0.001 0.001"/></geometry><material name="c_11_11_14"/></visual><visual><origin xyz="0 0 0" rpy="0 0 3.14159"/><geometry><mesh filename="package://wcr_proto/meshes/wheel_1.stl" scale="0.001 0.001 0.001"/></geometry><material name="c_ed_ea_e0"/></visual></link>
<joint name="BR_wheel_joint" type="continuous"><parent link="base_link"/><child link="BR_wheel_link"/><origin xyz="-0.10000 -0.09500 0.01750" rpy="0.00000 0.00000 0.00000"/><axis xyz="0 1 0"/></joint>
<link name="lidar_link"/>
<link name="imu_link"/>
<link name="wall_camera_link"/>
<link name="wall_camera_optical"/>
<link name="front_camera_link"/>
<link name="front_camera_optical"/>
<joint name="lidar_joint" type="fixed"><parent link="base_link"/><child link="lidar_link"/><origin xyz="-0.13900 0.00000 0.11000" rpy="0.00000 0.00000 0.00000"/></joint>
<joint name="imu_joint" type="fixed"><parent link="base_link"/><child link="imu_link"/><origin xyz="-0.11800 0.00600 0.01650" rpy="0.00000 0.00000 0.00000"/></joint>
<joint name="wall_camera_joint" type="fixed"><parent link="base_link"/><child link="wall_camera_link"/><origin xyz="0.15500 0.04000 0.09000" rpy="0.00000 1.22173 0.00000"/></joint>
<joint name="wall_camera_optical_joint" type="fixed"><parent link="wall_camera_link"/><child link="wall_camera_optical"/><origin xyz="0.00000 0.00000 0.00000" rpy="-1.57080 0.00000 -1.57080"/></joint>
<joint name="front_camera_joint" type="fixed"><parent link="base_link"/><child link="front_camera_link"/><origin xyz="0.14600 0.02200 0.06000" rpy="0.00000 0.00000 0.00000"/></joint>
<joint name="front_camera_optical_joint" type="fixed"><parent link="front_camera_link"/><child link="front_camera_optical"/><origin xyz="0.00000 0.00000 0.00000" rpy="-1.57080 0.00000 -1.57080"/></joint>
</robot>
