Deepak-EL/robro/(commit log)

2026-11-04 WCR prototype digital twin: CAD, Webots, URDF, ROS 2 / Nav2 / Foxglove on three dam faces
    The physical foam-board robot (A2212 1000 KV + 1045 prop thrust adhesion, 4 x N20 skid steer,
    L298N, ESP32, 40 A ESC) with a sensor kit (lidar, wall + front camera, IMU), in the winter dam,
    GoldenEye upstream and GoldenEye gorge worlds of wcr_dam_sim, whose nodes, layouts and maps it reuses.
    Autonomous coverage of the demo areas: 67.9 / 72.6 / 73.4 %. Tyre friction calibrated against the
    hand calculation (wsl_hold_test.sh); drive surface fitted to the drawn faces (fit_face.py).
    [body_0.obj, body_0.stl, body_1.obj, body_1.stl, body_10.obj, body_10.stl, body_11.obj, body_11.stl]
2026-11-04 Foxglove layout: look straight at the face (display frame map, fixed view over the demo area)
2026-11-04 Propeller spins in RViz / Foxglove: continuous prop_joint with a slow display angle from the driver
    [wcr_proto.urdf]
2026-11-04 Foxglove layout: camera follows the map frame (the face), not the world root
2026-11-04 Report material: docs/REPORT_DATA.md, docs/TEST_LOG.md, figures, final results, test scripts
    [inspection_log_goldeneye_dam.csv, inspection_log_goldeneye_gorge.csv, inspection_log_winter_dam.csv]
2026-11-06 Prototype v2: CAD (top deck, cross strip), Webots/ROS twin wcr_proto2, hold tests + 3 dam missions, wiring diagram, hardware photos and videos
    [body_0.obj, body_0.stl, body_1.obj, body_1.stl, body_10.obj, body_10.stl, body_11.obj, body_11.stl]
